TechIsCool/10w_RGB_LED/full.png

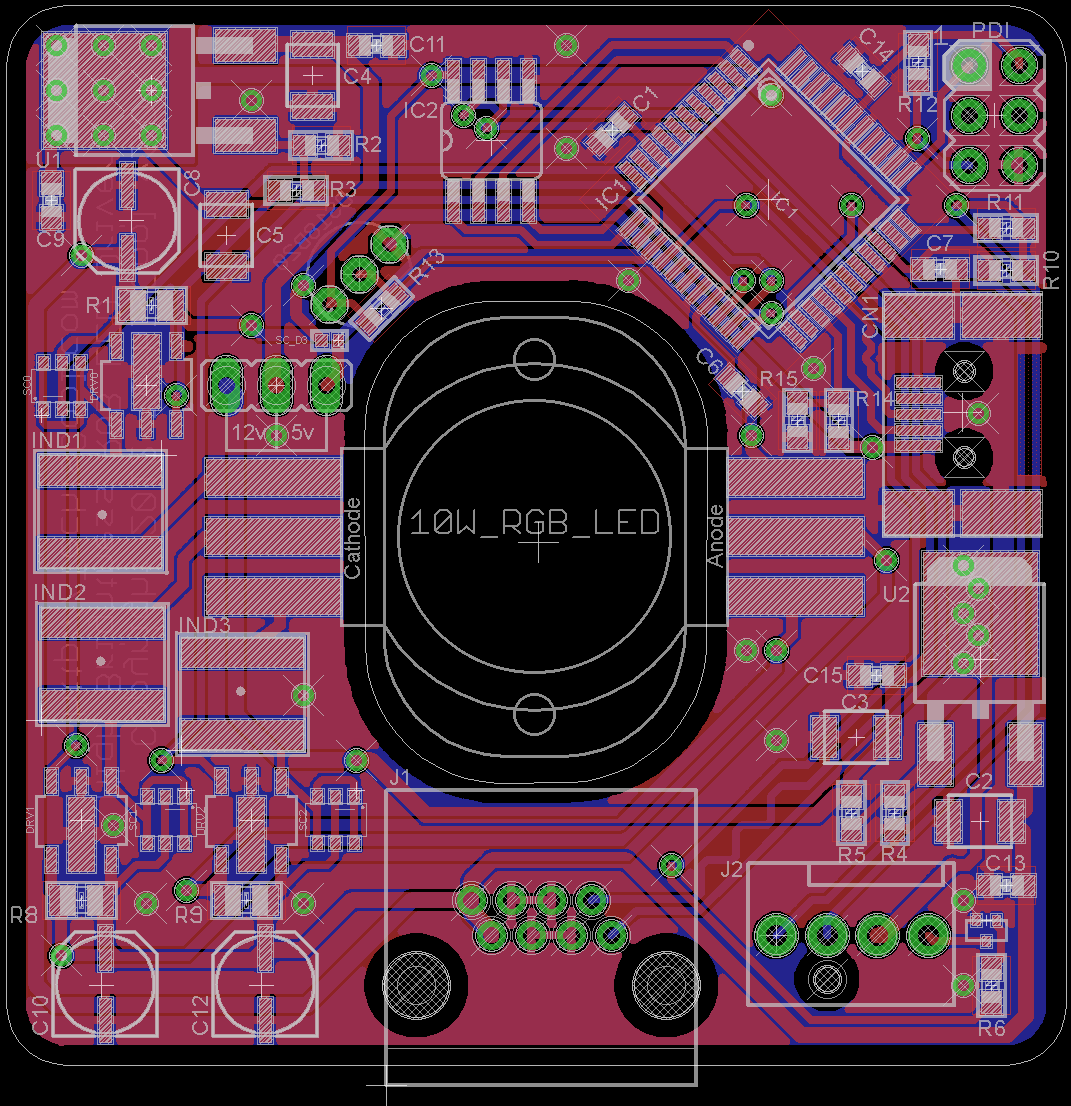
full.png
