TechIsCool/10w_RGB_LED/Outline.brd

## EAGLE design Outline.brd (2013-05-03)

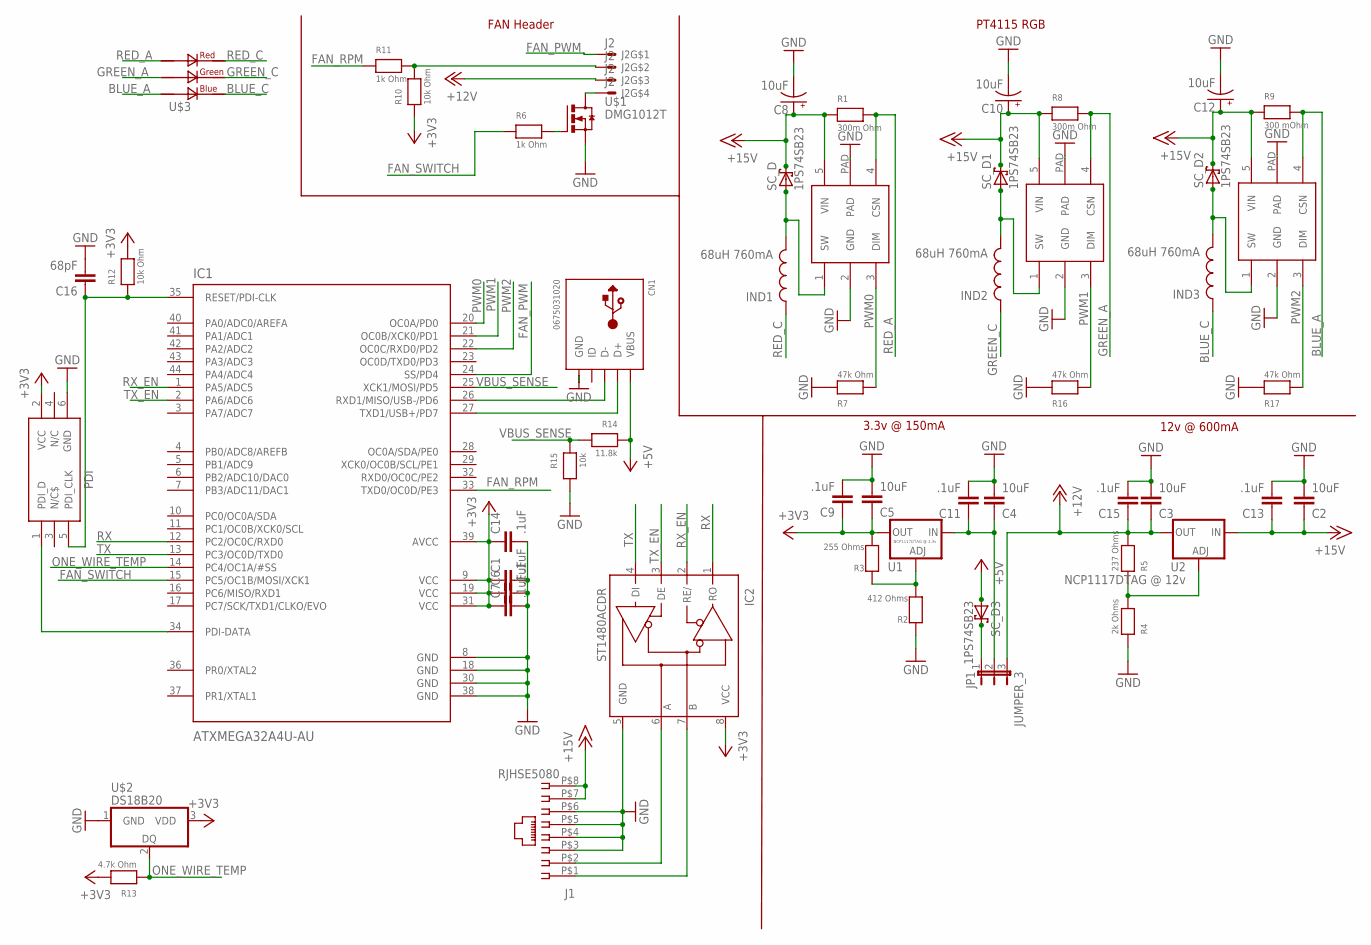
[picture p2: schematic Outline.sch]

Parts:
C1, C6, C7, C9, C11, C13, C14, C15: .1uF; 0603-CAP
C2, C3, C4, C5: 10uF; 1210
C8, C10, C12: 10uF; PANASONIC_C
C16: 68pF; 0603-CAP
CN1: 0675031020; MOLEX_675031020
DRV0, DRV1, DRV2: PT4115; SOT89-5
IC1: ATXMEGA32A4U-AU; TQFP-44
IC2: ST1480ACDR; SO08
IND1, IND2, IND3: 68uH 760mA; CR54
J1: RJHSE5080
J2: J2; 47053-1000
JP1: JUMPER_3; JP2E
PDI: AVR_PDI
R1, R8: 300m Ohm; 0805
R2: 412 Ohms; 0603
R3: 255 Ohms; 0603
R4: 2k Ohms; 0603
R5: 237 Ohms; 0603
R6, R11: 1k Ohm; 0603
R7, R16, R17: 47k Ohm; 0603
R9: 300 mOhm; 0805
R10, R12: 10k Ohm; 0603
R13: 4.7k Ohm; 0603
R14: 11.8k; 0603
R15: 10k; 0603
SC_D, SC_D1, SC_D2: 1PS74SB23; SOT-457
SC_D3: 1PS74SB23; NSR05F20
U1: NCP1117DTAG @ 3.3v; V-REG_DPACK
U2: NCP1117DTAG @ 12v; V-REG_DPACK
U$1: DMG1012T
U$2: DS18B20; TOP-92-INLINE
U$3: 10W_RGB_LED; 10W_LED

Connections:
+3V3: C1.1, C5.1, C6.1, C7.1, C9.1, C14.1, IC1.9 (VCC), IC1.19 (VCC), IC1.31 (VCC), IC1.39 (AVCC), IC2.8 (VCC), PDI.2 (VCC), R3.2, R10.1, R12.2, R13.2, U1.4 (OUT), U$2.3 (VDD)
+5V: CN1.P$1 (VBUS), R14.1, SC_D3.P$2 (A)
+12V: C3.1, C15.1, J2.3, JP1.3, R5.2, U2.4 (OUT)
+15V: C2.1, C8.+, C10.+, C12.+, C13.1, DRV0.5 (VIN), DRV1.5 (VIN), DRV2.5 (VIN), J1.P$7 (7), J1.P$8 (8), R1.1, R8.1, R9.1, SC_D.P$2 (C), SC_D.P$5 (C), SC_D1.P$2 (C), SC_D1.P$5 (C), SC_D2.P$2 (C), SC_D2.P$5 (C), U2.3 (IN)
BLUE_A: DRV2.4 (CSN), R9.2, U$3.B$A
BLUE_C: IND3.P$1 (1), U$3.B$C
FAN_PWM: IC1.24 (SS/PD4), J2.1
FAN_RPM: IC1.33 (TXD0/OC0D/PE3), R11.1
FAN_SWITCH: IC1.15 (PC5/OC1B/MOSI/XCK1), R6.1
GND: C1.2, C2.2, C3.2, C4.2, C5.2, C6.2, C7.2, C8.-, C9.2, C10.-, C11.2, C12.-, C13.2, C14.2, C15.2, C16.2, CN1.GND@1 (GND), CN1.GND@2 (GND), CN1.GND@3 (GND), CN1.GND@4 (GND), CN1.P$5 (GND), DRV0.2 (GND), DRV0.PAD, DRV1.2 (GND), DRV1.PAD, DRV2.2 (GND), DRV2.PAD, IC1.8 (GND), IC1.18 (GND), IC1.30 (GND), IC1.38 (GND), IC2.5 (GND), J1.P$3 (3), J1.P$4 (4), J1.P$5 (5), J1.P$6 (6), PDI.6 (GND), R2.1, R4.1, R7.1, R15.2, R16.1, R17.1, U$1.P$S (S), U$2.1 (GND)
GREEN_A: DRV1.4 (CSN), R8.2, U$3.G$A
GREEN_C: IND2.P$1 (1), U$3.G$C
unnamed: R2.2, R3.1, U1.1 (ADJ)
unnamed: R4.2, R5.1, U2.1 (ADJ)
unnamed: J2.4, U$1.P$D (D)
unnamed: R6.2, U$1.P$G (G)
unnamed: JP1.1, SC_D3.P$1 (C)
unnamed: DRV0.1 (SW), IND1.P$2 (2), SC_D.P$1 (A), SC_D.P$3 (A), SC_D.P$4 (A), SC_D.P$6 (A)
unnamed: DRV1.1 (SW), IND2.P$2 (2), SC_D1.P$1 (A), SC_D1.P$3 (A), SC_D1.P$4 (A), SC_D1.P$6 (A)
unnamed: DRV2.1 (SW), IND3.P$2 (2), SC_D2.P$1 (A), SC_D2.P$3 (A), SC_D2.P$4 (A), SC_D2.P$6 (A)
unnamed: IC1.34 (PDI-DATA), PDI.1 (PDI_D)
unnamed: C4.1, C11.1, JP1.2, U1.3 (IN)
unnamed: C16.1, IC1.35 (RESET/PDI-CLK), PDI.5 (PDI_CLK), R12.1
unnamed: J2.2, R10.2, R11.2
ONE_WIRE_TEMP: IC1.14 (PC4/OC1A/#SS), R13.1, U$2.2 (DQ)
PWM0: DRV0.3 (DIM), IC1.20 (OC0A/PD0), R7.2
PWM1: DRV1.3 (DIM), IC1.21 (OC0B/XCK0/PD1), R16.2
PWM2: DRV2.3 (DIM), IC1.22 (OC0C/RXD0/PD2), R17.2
RED_A: DRV0.4 (CSN), R1.2, U$3.R$A
RED_C: IND1.P$1 (1), U$3.R$C
RS485_N: IC2.7 (B), J1.P$1 (1)
RS485_P: IC2.6 (A), J1.P$2 (2)
RX: IC1.12 (PC2/OC0C/RXD0), IC2.1 (RO)
RX_EN: IC1.1 (PA5/ADC5), IC2.2 (RE/)
TX: IC1.13 (PC3/OC0D/TXD0), IC2.4 (DI)
TX_EN: IC1.2 (PA6/ADC6), IC2.3 (DE)
USB+: CN1.P$3 (D+), IC1.27 (TXD1/USB+/PD7)
USB-: CN1.P$2 (D-), IC1.26 (RXD1/MISO/USB-/PD6)
VBUS_SENSE: IC1.25 (XCK1/MOSI/PD5), R14.2, R15.1

Notes on the sheet:
3.3v @ 150mA
12v @ 600mA
PT4115 RGB
FAN Header

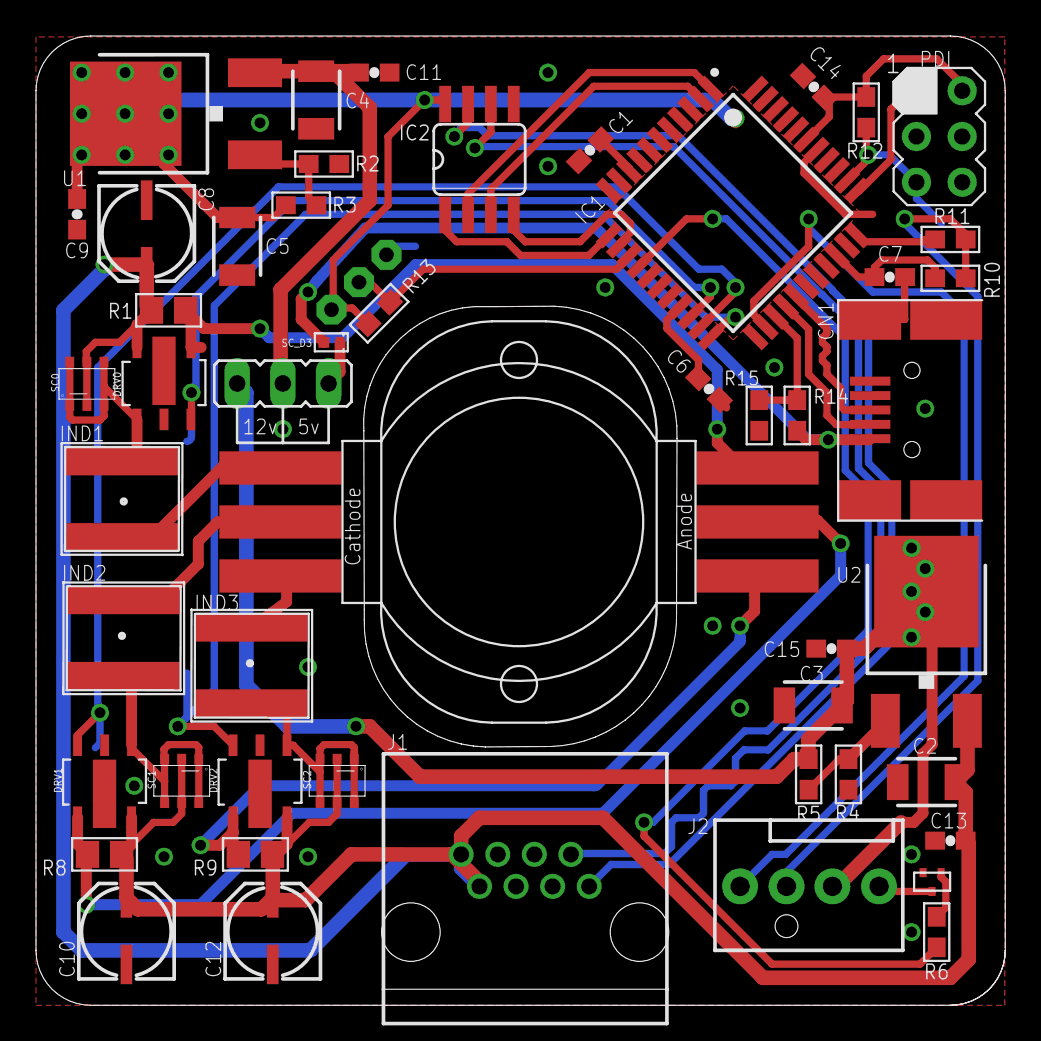
[picture p3: board Outline.brd from above]

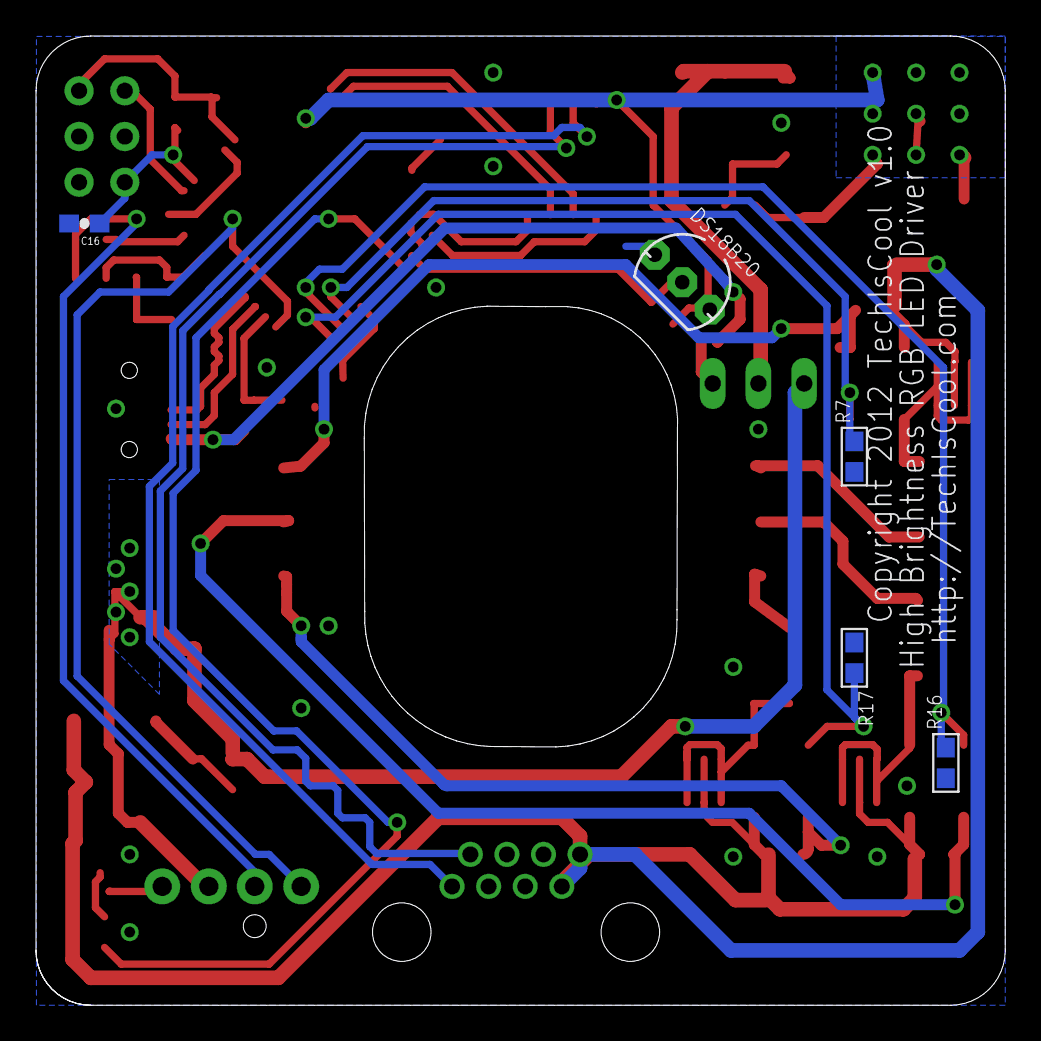
[picture p4: board Outline.brd from below]

Board: 2 copper layers, 53.8 x 53.8 mm, 55 parts (5 on the bottom side), 39 nets.
