TechIsCool/10w_RGB_LED/(commit log)

2012-12-18 2011 Commit
    [LED Controller 2011.brd, LED Controller 2011.sch]
2012-12-18 2012 Commit
    [LED Controller 2011.brd, LED Controller 2011.sch, Outline.brd, Outline.sch]
2012-12-18 Version 2
    [Outline.sch]
2012-12-18 Version 3
    [Outline.brd, Outline.sch]
2012-12-18 Version 4
    [Outline.brd, Outline.sch]
2012-12-18 Version 4.1
    [Outline.brd, Outline.sch]
2012-12-19 Cleaned Up some
    Still have a trace broken though
    [Outline.brd, Outline.sch]
2012-12-19 Still have an airwire
    Not sure why
    [Outline.brd]
2012-12-19 Version 4.1a
    Found the issue
    [Outline.brd]
2012-12-20 4.2
    Rounded Corners with some final touch up.
    [Outline.brd]
2012-12-22 4.2.1
    Updated Layout
    [Outline.brd, Outline.sch]
2012-12-22 4.2.2
    Connected a few things and add a via. Also gnded the extra wires in the
    RJ45 cable
    [Outline.brd, Outline.sch]
2012-12-22 4.2.3
    Aligned the via's
    [Outline.brd]
2012-12-25 4.2.4
    Final Version Submitted aka v1.0
    [Outline.brd, Outline.sch]
2013-05-03 4.3
    Changed LDO resistor values to stop overheating. Added 68pf cap between
    reset and ground to make AVR Dragon talk with device.
    [Outline.brd, Outline.sch]
