TechIsCool/10w_RGB_LED/(notices)

Notices in the files:
Outline.brd:
Copyright 2012 TechIsCool v1.0
parts and their libraries:
SparkFun: Licensing: CC v3.0 Share-Alike You are welcome to use this library for commercial purposes.
